kylechiu3201/ECE-445-Project/documents/progress reports/kyle/ECE 445 Progress Report 1.docx

ECE 445 Weekly Progress Sheet

Name:__Kyle Chiu_________________________________ Partner Names:__Taylor Plummer, Brandon Wong____

Group Number:__19_______________________________ Date:___2/15/2022______________________________

Instructions: This form is to be filled out on a weekly basis for TA meetings so that your TA can get progress updates and track project development for everyone in your team. This is an individual submission so everyone on your team is personally responsible for filling out the form and emailing it to your TA. You will use these forms at the end of the semester to create an update of your weekly deliverables schedule to compare to your original project execution plan.

Team Accomplishments

The bulk of the work that we accomplished last week was the Project Proposal.

Team Delays

We did not have any other objectives planned last week.

Objectives from Last Week

Copy paste “Deliverables for Next Week” and classify each bullet as follows:

- Objective 1 In-Progress
  - Subtask 1 Complete
  - Subtask 2 In-Progress
- Objective 2 Incomplete

Deliverables for Next Week:
| Student Weekly Objectives: • Design PCB ◦ Sketch a mockup of PCB ◦ Create CAD files for the PCB
| TA Comments/Revisions: (TA feedback on “Weekly Objectives.” This section is intended to keep you on track towards project completion. It will be emailed back to you at the end of your TA meeting if any revisions are necessary. They will become part of your weekly objectives to discuss at the next TA meeting.)

Remaining Tasks:

• Design PCB

• Create PCB CAD design

• Write code for microcontroller

• Order PCB and hardware

• Assemble hardware onto PCB and program microcontroller

• Write Windows software and Chrome browser extension software

• Test hardware functionality

• Test device functionality
