kylechiu3201/ECE-445-Project/documents/progress reports/kyle/ECE 445 Progress Report 6.docx

ECE 445 Weekly Progress Sheet

Name:_Kyle Chiu__________________________________ Partner Names:_Taylor Plummer, Brandon Wong_____

Group Number:_19________________________________ Date:__04/05/2022_______________________________

Instructions: This form is to be filled out on a weekly basis for TA meetings so that your TA can get progress updates and track project development for everyone in your team. This is an individual submission so everyone on your team is personally responsible for filling out the form and emailing it to your TA. You will use these forms at the end of the semester to create an update of your weekly deliverables schedule to compare to your original project execution plan.

Team Accomplishments

Continued working on software functionality like the GUI and started looking into enclosure details. Parts literally came in yesterday so we can finally start working on the hardware for this upcoming week.

Team Delays

Similar to last week since parts didn’t arrive until April 4th, which was yesterday. A few group members (myself included) were busy so we were unable to meet up at ECEB to divide parts and discuss further logistics, but we should be able to get many things done now that we actually have the hardware.

Objectives from Last Week

- Start breadboard prototyping device In Progress
- Solder parts to PCB Incomplete
- Finish software functionality for all software components In Progress

Deliverables for Next Week:
| Student Weekly Objectives: - Start breadboard prototyping device - Solder parts to PCB - Finish software functionality for all software components - Test Bluetooth functionality and pairing with host device
| TA Comments/Revisions: (TA feedback on “Weekly Objectives.” This section is intended to keep you on track towards project completion. It will be emailed back to you at the end of your TA meeting if any revisions are necessary. They will become part of your weekly objectives to discuss at the next TA meeting.)

Remaining Tasks:

• Write code for microcontroller

• Assemble hardware onto PCB and program microcontroller

• Write Windows software and Chrome browser extension software

• Test hardware functionality

• Test device functionality
