kylechiu3201/ECE-445-Project/documents/progress reports/kyle/ECE 445 Progress Report 7.docx

ECE 445 Weekly Progress Sheet

Name:_Kyle Chiu__________________________________ Partner Names:_Taylor Plummer, Brandon Wong_____

Group Number:_19________________________________ Date:__04/12/2022_______________________________

Instructions: This form is to be filled out on a weekly basis for TA meetings so that your TA can get progress updates and track project development for everyone in your team. This is an individual submission so everyone on your team is personally responsible for filling out the form and emailing it to your TA. You will use these forms at the end of the semester to create an update of your weekly deliverables schedule to compare to your original project execution plan.

Team Accomplishments

We all met in ECEB and together we were able to test the button, IR sensor, and the piezo buzzer functionality with the ESP32. After taking a look at our first round PCB, we discovered physical incompatibility issues with our PCB which will be present with our second round PCB as well, so we had to redesign and order another PCB on our own dime. Bluetooth connection worked and we were able to connect our laptop to the ESP32.

Team Delays

All of our sensors/outputs are tested with the ESP32, but we didn’t test the ICs, one reason being that the first round PCB was designed with a different boost converter IC which wasn’t in stock so we had to switch to a different design, and the footprint for our 3.3v voltage regulator was an SMD IC on the PCB when it should have been a through-hole component. Our second round PCB solves the first boost converter issue but the 3.3v regulator was still an issue, not to mention that the pins for our ESP32 didn’t match the size of the holes we added on the PCB, nor were there enough pins since the original design for the PCB was based on a different version of the ESP32 but we were not aware of this. Bluetooth testing worked fine but in order to send data to the ESP32 we utilized a weird Bluetooth terminal program, but we would need to replicate this terminal within our own application in order to send data.

Objectives from Last Week

- Start breadboard prototyping device Basically Complete
- Solder parts to PCB Incomplete
- Finish software functionality for all software components In Progress
- Test Bluetooth functionality and pairing with host device Complete

Deliverables for Next Week:
| Student Weekly Objectives: • Write code for microcontroller • Solder parts to PCB • Finish solftware functionality for all software components • Assemble hardware onto PCB and program microcontroller
| TA Comments/Revisions: (TA feedback on “Weekly Objectives.” This section is intended to keep you on track towards project completion. It will be emailed back to you at the end of your TA meeting if any revisions are necessary. They will become part of your weekly objectives to discuss at the next TA meeting.)

Remaining Tasks:

• Write code for microcontroller

• Assemble hardware onto PCB and program microcontroller

• Write Windows software and Chrome browser extension software

• Test device functionality
