kylechiu3201/ECE-445-Project/documents/progress reports/taylor/ECE_445_Weekly_Progress_report_3.docx

ECE 445 Weekly Progress Sheet

Name:_Taylor Plummer Partner Names: Kyle Chiu, Brandon Wong

Group Number:_19 Date: 2/15/2022

Instructions: This form is to be filled out on a weekly basis for TA meetings so that your TA can get progress updates and track project development for everyone in your team. This is an individual submission so everyone on your team is personally responsible for filling out the form and emailing it to your TA. You will use these forms at the end of the semester to create an update of your weekly deliverables schedule to compare to your original project execution plan.

Team Accomplishments

Chrome Extension

Pcb rough draft

Updated design to add new components and add to complexity.

Team Delays

Haven’t ordered parts because we need to confirm our updated design

Objectives from Last Week

Copy paste “Deliverables for Next Week” and classify each bullet as follows:

- Refine PCB, got to pcb review - Done
- Work on a chrome extension - Done
- Start ordering parts we will need – not done

Deliverables for Next Week:
| Student Weekly Objectives: Create a set of tasks to accomplish for the week and detail subtasks. You should be pulling the next task from your “remaining tasks” section up to this point to work on and keeping incomplete tasks in this section. - Investigate using pyshark to retrieve website data. Chrome extension is very isolated. - Order parts - Start writing microcontroller code
| TA Comments/Revisions: (TA feedback on “Weekly Objectives.” This section is intended to keep you on track towards project completion. It will be emailed back to you at the end of your TA meeting if any revisions are necessary. They will become part of your weekly objectives to discuss at the next TA meeting.)

Remaining Tasks:

Finalize PCB

Finalize software

Code microcontroller

Order parts

Assemble hardware

Test hardware

Test device
