kylechiu3201/ECE-445-Project/documents/progress reports/taylor/ECE_445_Weekly_Progress_report_6.docx

ECE 445 Weekly Progress Sheet

Name:_Taylor Plummer Partner Names: Kyle Chiu, Brandon Wong

Group Number:_19 Date: 3/29/2022

Instructions: This form is to be filled out on a weekly basis for TA meetings so that your TA can get progress updates and track project development for everyone in your team. This is an individual submission so everyone on your team is personally responsible for filling out the form and emailing it to your TA. You will use these forms at the end of the semester to create an update of your weekly deliverables schedule to compare to your original project execution plan.

Team Accomplishments

Some software upgrades.

Parts have arrived and hardware can now be tested.

Team Delays

Don’t want to solder until second set of pcbs come because limited amount of important parts.

Objectives from Last Week

Copy paste “Deliverables for Next Week” and classify each bullet as follows:

- Figure out basic Bluetooth connection (once Bluetooth module is available) – Bluetooth module just arrived

Deliverables for Next Week:
| Student Weekly Objectives: Create a set of tasks to accomplish for the week and detail subtasks. You should be pulling the next task from your “remaining tasks” section up to this point to work on and keeping incomplete tasks in this section. - Test the components - When board arrives, solder
| TA Comments/Revisions: (TA feedback on “Weekly Objectives.” This section is intended to keep you on track towards project completion. It will be emailed back to you at the end of your TA meeting if any revisions are necessary. They will become part of your weekly objectives to discuss at the next TA meeting.)

Remaining Tasks:

Finalize PCB

Finalize software

Code microcontroller

Assemble hardware

Test hardware

Test device
