kylechiu3201/ECE-445-Project/documents/progress reports/taylor/ECE_445_Weekly_Progress_report_7.docx

ECE 445 Weekly Progress Sheet

Name:_Taylor Plummer Partner Names: Kyle Chiu, Brandon Wong

Group Number:_19 Date: 4/12/2022

Instructions: This form is to be filled out on a weekly basis for TA meetings so that your TA can get progress updates and track project development for everyone in your team. This is an individual submission so everyone on your team is personally responsible for filling out the form and emailing it to your TA. You will use these forms at the end of the semester to create an update of your weekly deliverables schedule to compare to your original project execution plan.

Team Accomplishments

Ordered new pcb

Tested sensors and outputs

Team Delays

Did not solder because 2nd round pcb has not come yet and 1st and 2nd pcbs are rather different

Objectives from Last Week

Copy paste “Deliverables for Next Week” and classify each bullet as follows:

- Test the components - Done
- When board arrives, solder -proper board isn’t here yet
- Bluetooth connection – Connection done, Bluetooth still working on

Deliverables for Next Week:
| Student Weekly Objectives: Create a set of tasks to accomplish for the week and detail subtasks. You should be pulling the next task from your “remaining tasks” section up to this point to work on and keeping incomplete tasks in this section. - Finish microcontroller code – Should just be a few touch ups and testing - Solder board - Test
| TA Comments/Revisions: (TA feedback on “Weekly Objectives.” This section is intended to keep you on track towards project completion. It will be emailed back to you at the end of your TA meeting if any revisions are necessary. They will become part of your weekly objectives to discuss at the next TA meeting.)

Remaining Tasks:

Code microcontroller

Assemble hardware

Test hardware

Test device
