kylechiu3201/ECE-445-Project/images/pcb_draft.png

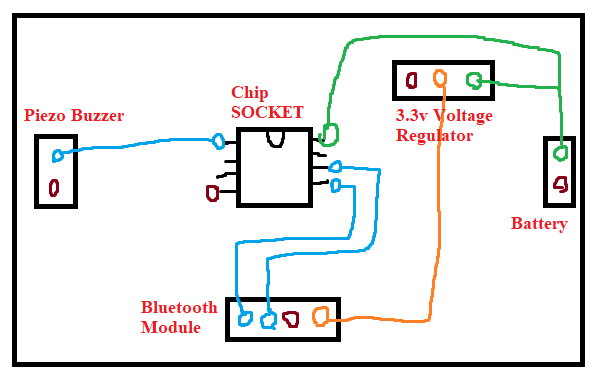
images/pcb_draft.png
