kylechiu3201/ECE-445-Project/notebooks/brandon/ECE445_PCB_Board.JPG

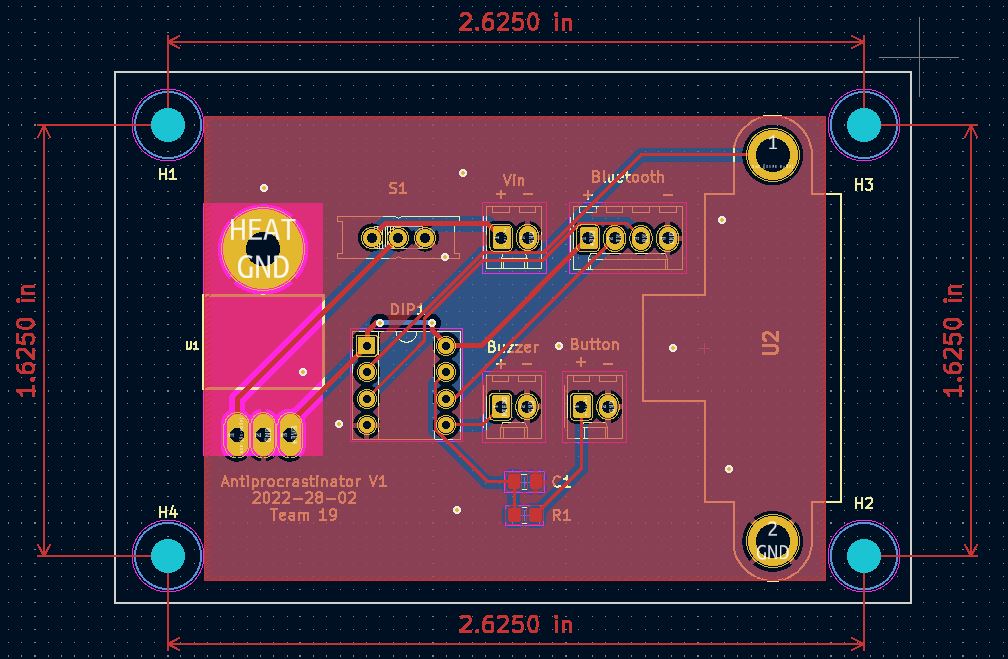
notebooks/brandon/ECE445_PCB_Board.JPG
