kylechiu3201/ECE-445-Project/notebooks/brandon/ECE445_Schematic.JPG

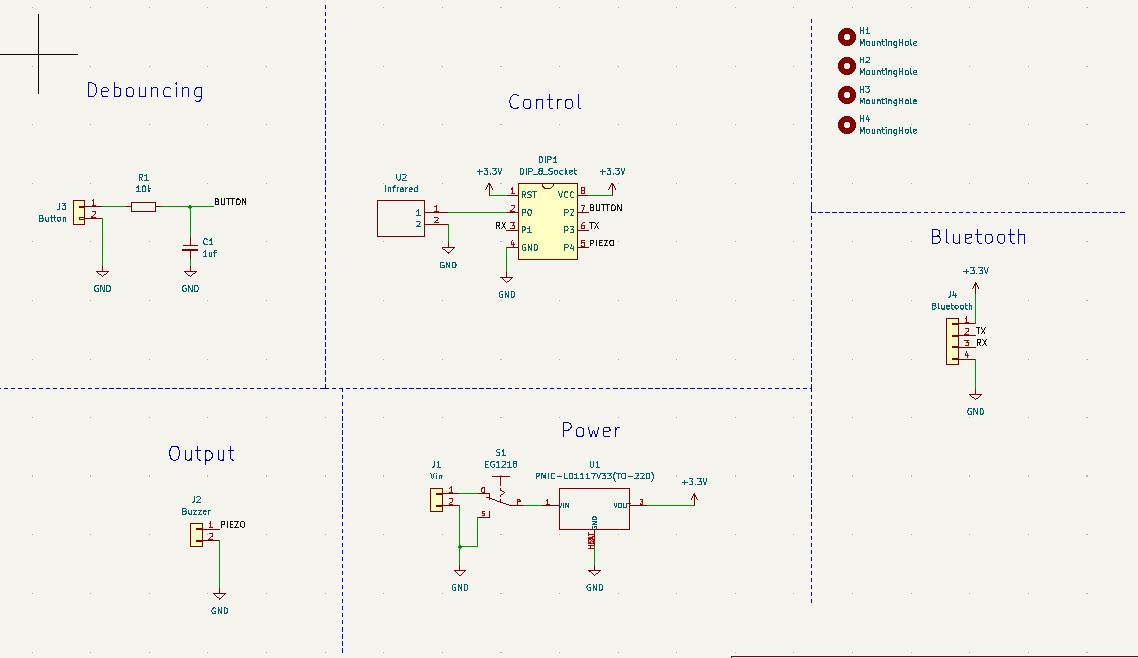
notebooks/brandon/ECE445_Schematic.JPG
