kylechiu3201/ECE-445-Project/kicad_files/antiprocrastinator_device/antiprocrastinator_device.kicad_pcb

## KiCad design kicad_files/antiprocrastinator_device/antiprocrastinator_device.kicad_pcb (2022-05-31)

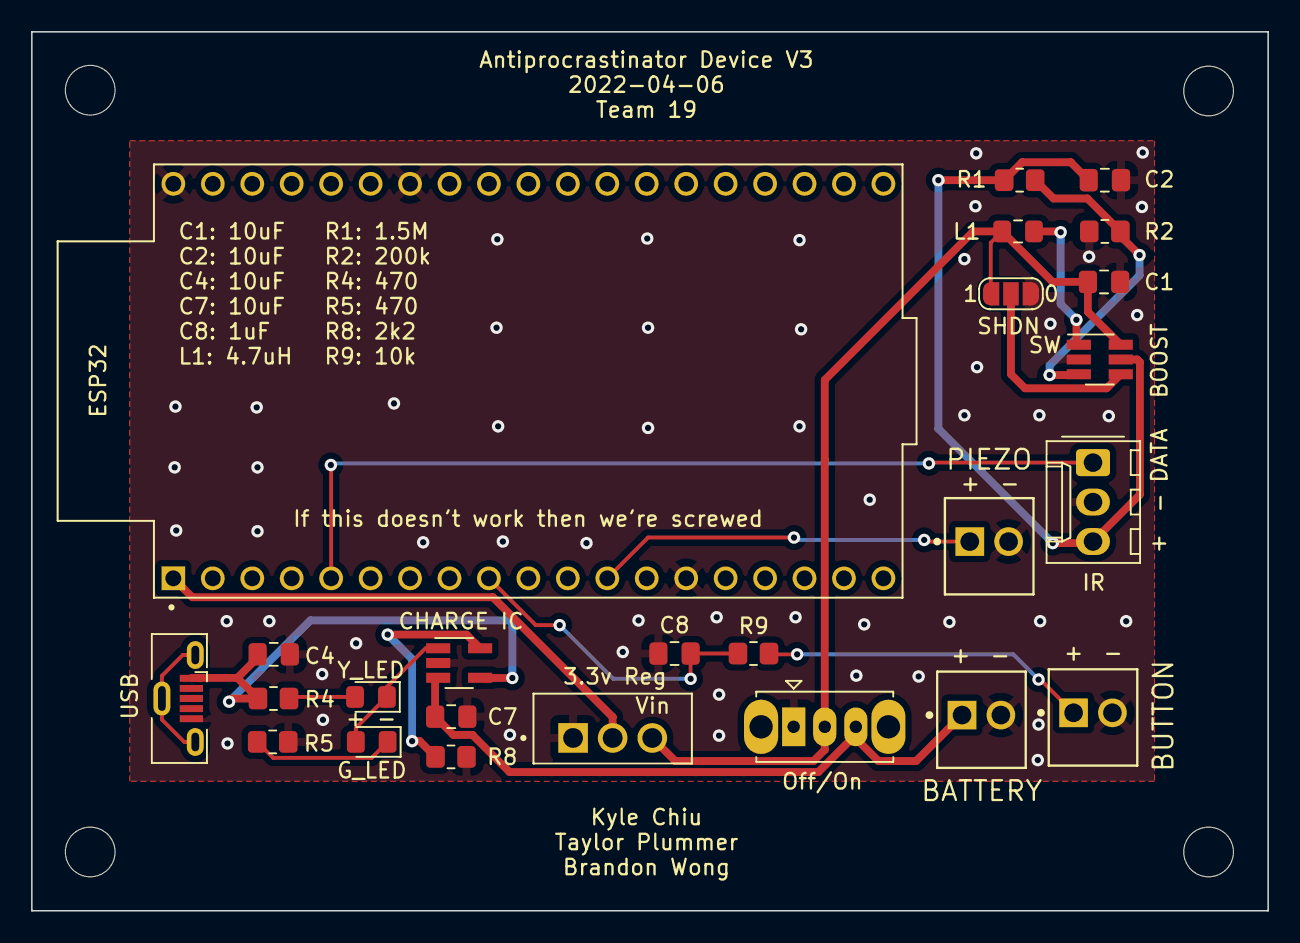
[picture p12: board antiprocrastinator_device.kicad_pcb from above]

Board: 2 copper layers, 79.6 x 56.6 mm, 29 parts (0 on the bottom side), 17 nets.

Parts:
3.3v Reg: 3.3v-Reg; TO255P1020X450X1968-3
BOOST: Boost Converter; SOT-23-6_Handsoldering
C1, C2, C4, C7: 10uF; C_0805_2012Metric_Pad1.18x1.45mm_HandSolder
C8: 1uF; C_0805_2012Metric_Pad1.18x1.45mm_HandSolder
CHARGE IC: BATT_IC; SOT-23-5_HandSoldering
D2: Y_LED; LED_0805_2012Metric_Pad1.15x1.40mm_HandSolder
D3: G_LED; LED_0805_2012Metric_Pad1.15x1.40mm_HandSolder
ESP32: ESP32; MODULE_ESP32-DEVKITC-32U
H1, H2, H3, H4: MountingHole; MountingHole_3.2mm_M3
J5: PIEZO; Molex-22-04-1021-MFG
J6: BATTERY; Molex-22-04-1021-MFG
J7: BUTTON; Molex-22-04-1021-MFG
J9: IR; Molex_KK-254_AE-6410-03A_1x03_P2.54mm_Vertical
L1: 4.7uH; L_0805_2012Metric_Pad1.15x1.40mm_HandSolder
Off/On: SW_SPDT; SW_Slide_1P2T_CK_OS102011MS2Q
R1: 1.5M; R_0805_2012Metric_Pad1.20x1.40mm_HandSolder
R2: 200k; R_0805_2012Metric_Pad1.20x1.40mm_HandSolder
R4, R5: 470R; R_0805_2012Metric_Pad1.20x1.40mm_HandSolder
R8: 2K2; R_0805_2012Metric_Pad1.20x1.40mm_HandSolder
R9: 10k; R_0805_2012Metric_Pad1.20x1.40mm_HandSolder
SHDN: SolderJumper_3_Open; SolderJumper-3_P1.3mm_Open_RoundedPad1.0x1.5mm_NumberLabels
USB: USB_B_Micro; USB_Micro-B_Molex-105133-0001

Connections:
+3V3: 3.3v Reg.2 (VOUT), ESP32.1 (3V3)
/BATT_OUT: 3.3v Reg.3 (VIN), BOOST.6 (VIN), C1.1, L1.1, Off/On.2 (B), SHDN.1 (A)
/BOOST_FB: BOOST.3 (FB), R1.2, R2.1
/BOOST_SHDN: BOOST.4 (~SHDN), SHDN.2 (C)
/BOOST_SW: BOOST.1 (SW), L1.2
/BOOST_VOUT: BOOST.5 (VOUT), C2.1, J9.3, R1.1
/BUTTON: C8.1, ESP32.9 (IO25), R9.2
/IR_DATA: ESP32.5 (IO34), J9.1
/PIEZO: ESP32.12 (IO14), J5.1
GND: 3.3v Reg.1 (ADJ/GND), BOOST.2 (GND), C1.2, C2.2, C4.2, C7.2, C8.2, CHARGE IC.2 (VSS), ESP32.14 (GND1), ESP32.32 (GND2), ESP32.38 (GND3), J5.2, J6.2, J7.2, J9.2, Off/On.1 (A), R2.2, R5.2, R8.2, SHDN.3 (B), USB.5 (GND)
unnamed: C4.1, CHARGE IC.4 (VDD), R4.1, USB.1 (VBUS)
unnamed: C7.1, CHARGE IC.3 (VBAT), J6.1, Off/On.3 (C)
unnamed: CHARGE IC.1 (STAT), D2.1 (K), D3.2 (A)
unnamed: D2.2 (A), R4.2
unnamed: D3.1 (K), R5.1
unnamed: J7.1, R9.1
unnamed: CHARGE IC.5 (PROG), R8.1
