kylechiu3201/ECE-445-Project/notebooks/brandon/bjwong3_antiprocrastinator.kicad_pcb

## KiCad design notebooks/brandon/bjwong3_antiprocrastinator.kicad_pcb (2022-05-31)

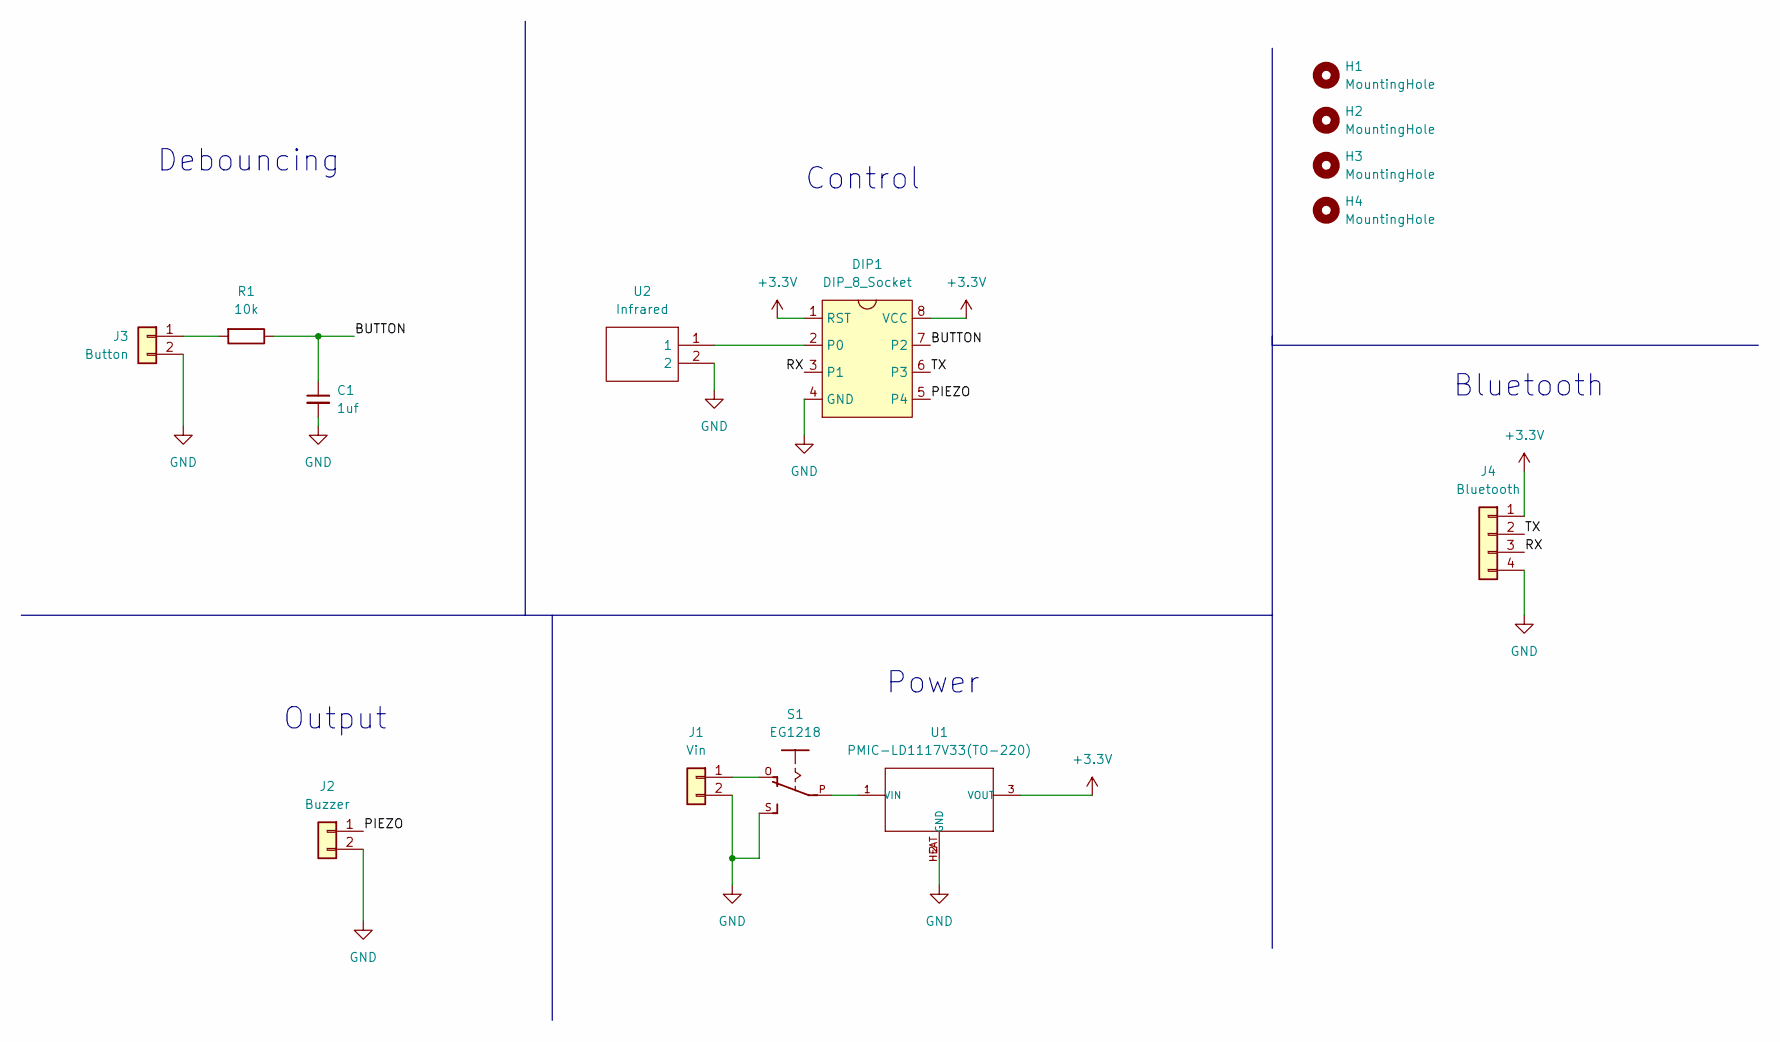
[picture p13: schematic bjwong3_antiprocrastinator.kicad_sch]

Parts:
C1: 1uf; C_0805_2012Metric_Pad1.18x1.45mm_HandSolder
DIP1: DIP_8_Socket; DIP-8_W7.62mm_Socket
H1, H2, H3, H4: MountingHole; MountingHole_3.2mm_M3
J1: Vin; Molex_KK-254_AE-6410-02A_1x02_P2.54mm_Vertical
J2: Buzzer; Molex_KK-254_AE-6410-02A_1x02_P2.54mm_Vertical
J3: Button; Molex_KK-254_AE-6410-02A_1x02_P2.54mm_Vertical
J4: Bluetooth; Molex_KK-254_AE-6410-04A_1x04_P2.54mm_Vertical
R1: 10k; R_0805_2012Metric_Pad1.20x1.40mm_HandSolder
S1: EG1218
U1: PMIC-LD1117V33(TO-220); TO-220; MPN LD1117V33
U2: Infrared; GP2Y0A21YK0F; Manufacturer_Part_Number GP2Y0A21YK0F; Mouser Part Number 852-GP2Y0A21YK0F

Connections:
+3V3: DIP1.1 (RST), DIP1.8 (VCC), J4.1, U1.3 (VOUT)
/BUTTON: C1.1, DIP1.7 (P2), R1.1
/PIEZO: DIP1.5 (P4), J2.1
/RX: DIP1.3 (P1), J4.3
/TX: DIP1.6 (P3), J4.2
GND: C1.2, DIP1.4 (GND), J1.2, J2.2, J3.2, J4.4, S1.S, U1.2 (GND), U1.HEAT (GND), U2.2
unnamed: DIP1.2 (P0), U2.1
unnamed: J3.1, R1.2
unnamed: J1.1, S1.O
unnamed: S1.P, U1.1 (VIN)

Notes on the sheet:
Bluetooth
Power
Debouncing
Output
Control

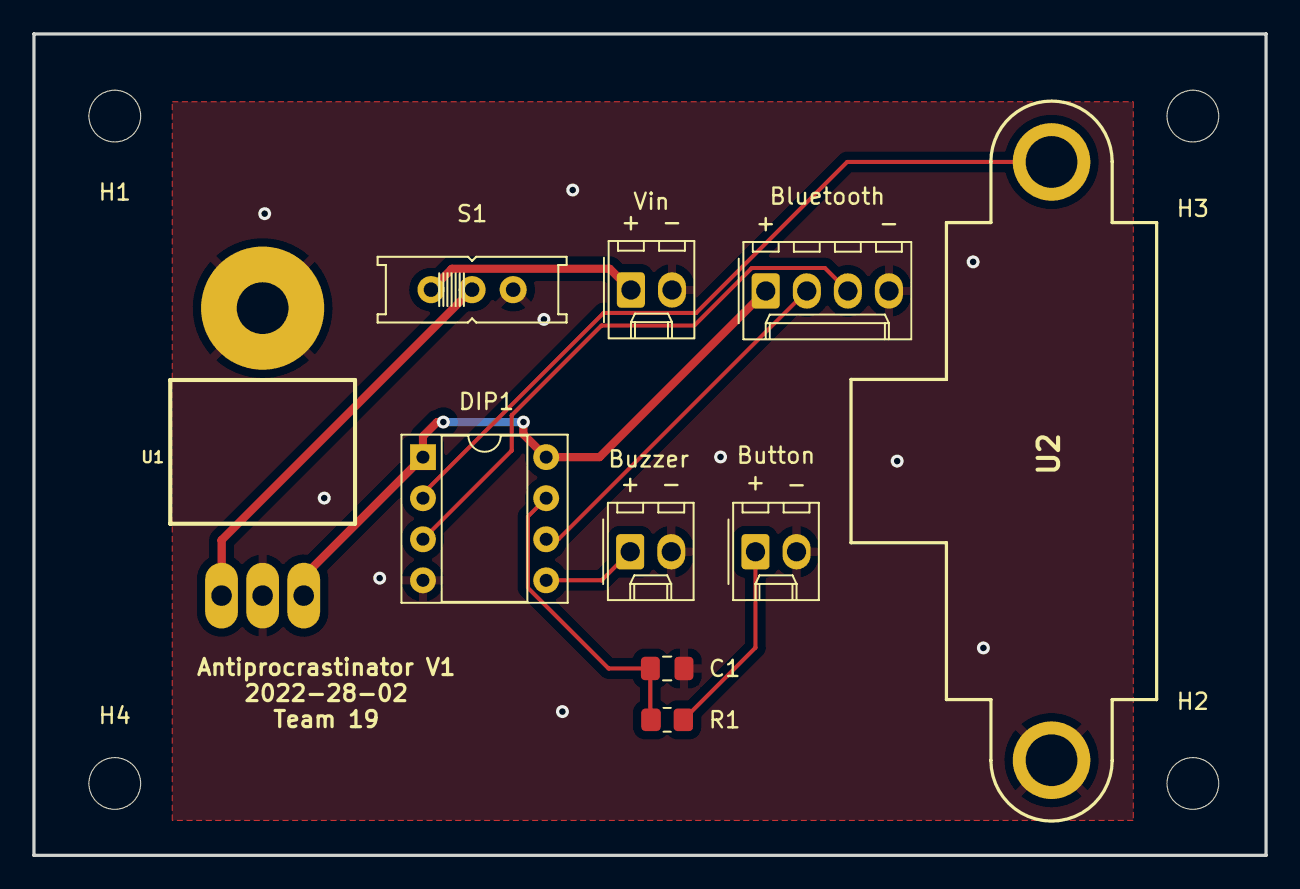
[picture p14: board bjwong3_antiprocrastinator.kicad_pcb from above]

Board: 2 copper layers, 76.2 x 50.8 mm, 14 parts (0 on the bottom side), 10 nets.
